yaozong1/Roam_pcba/(list of files, drawings)

Other design files:
roam.dsn
