yaozong1/Roam_pcba/roam.kicad_pcb

## KiCad design roam.kicad_pcb (2023-02-08)

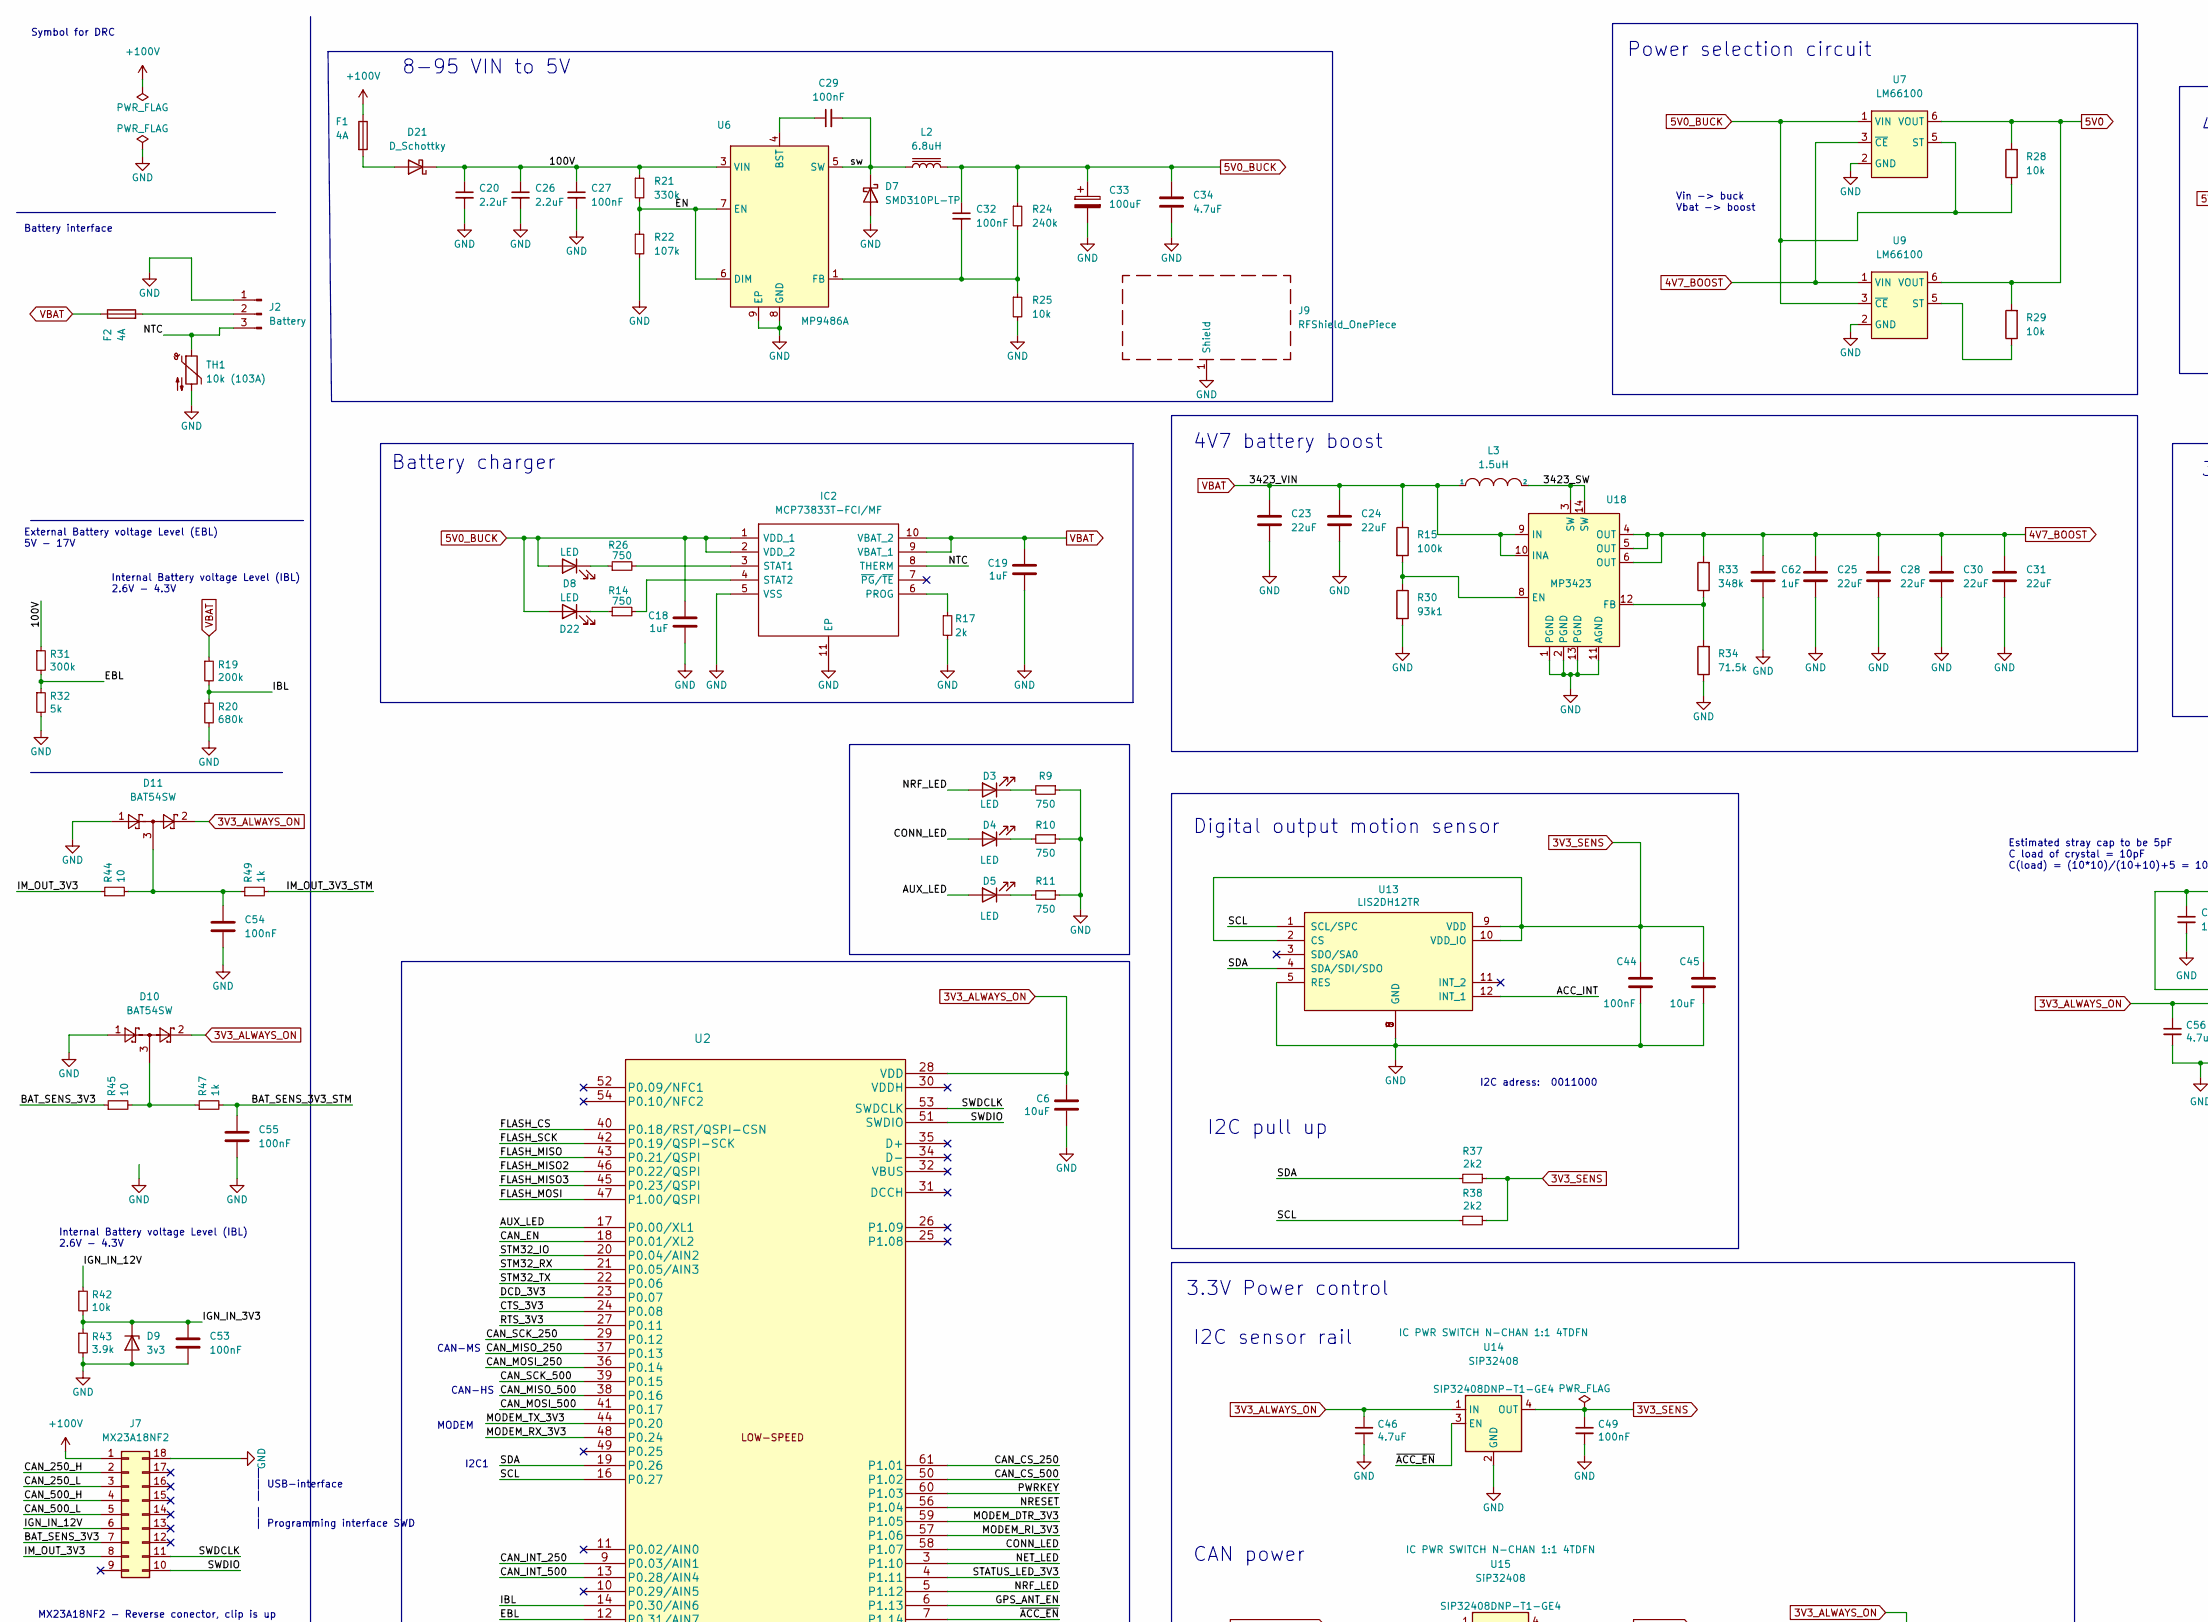
[picture p1: schematic roam.kicad_sch, part in row 1, column 1]

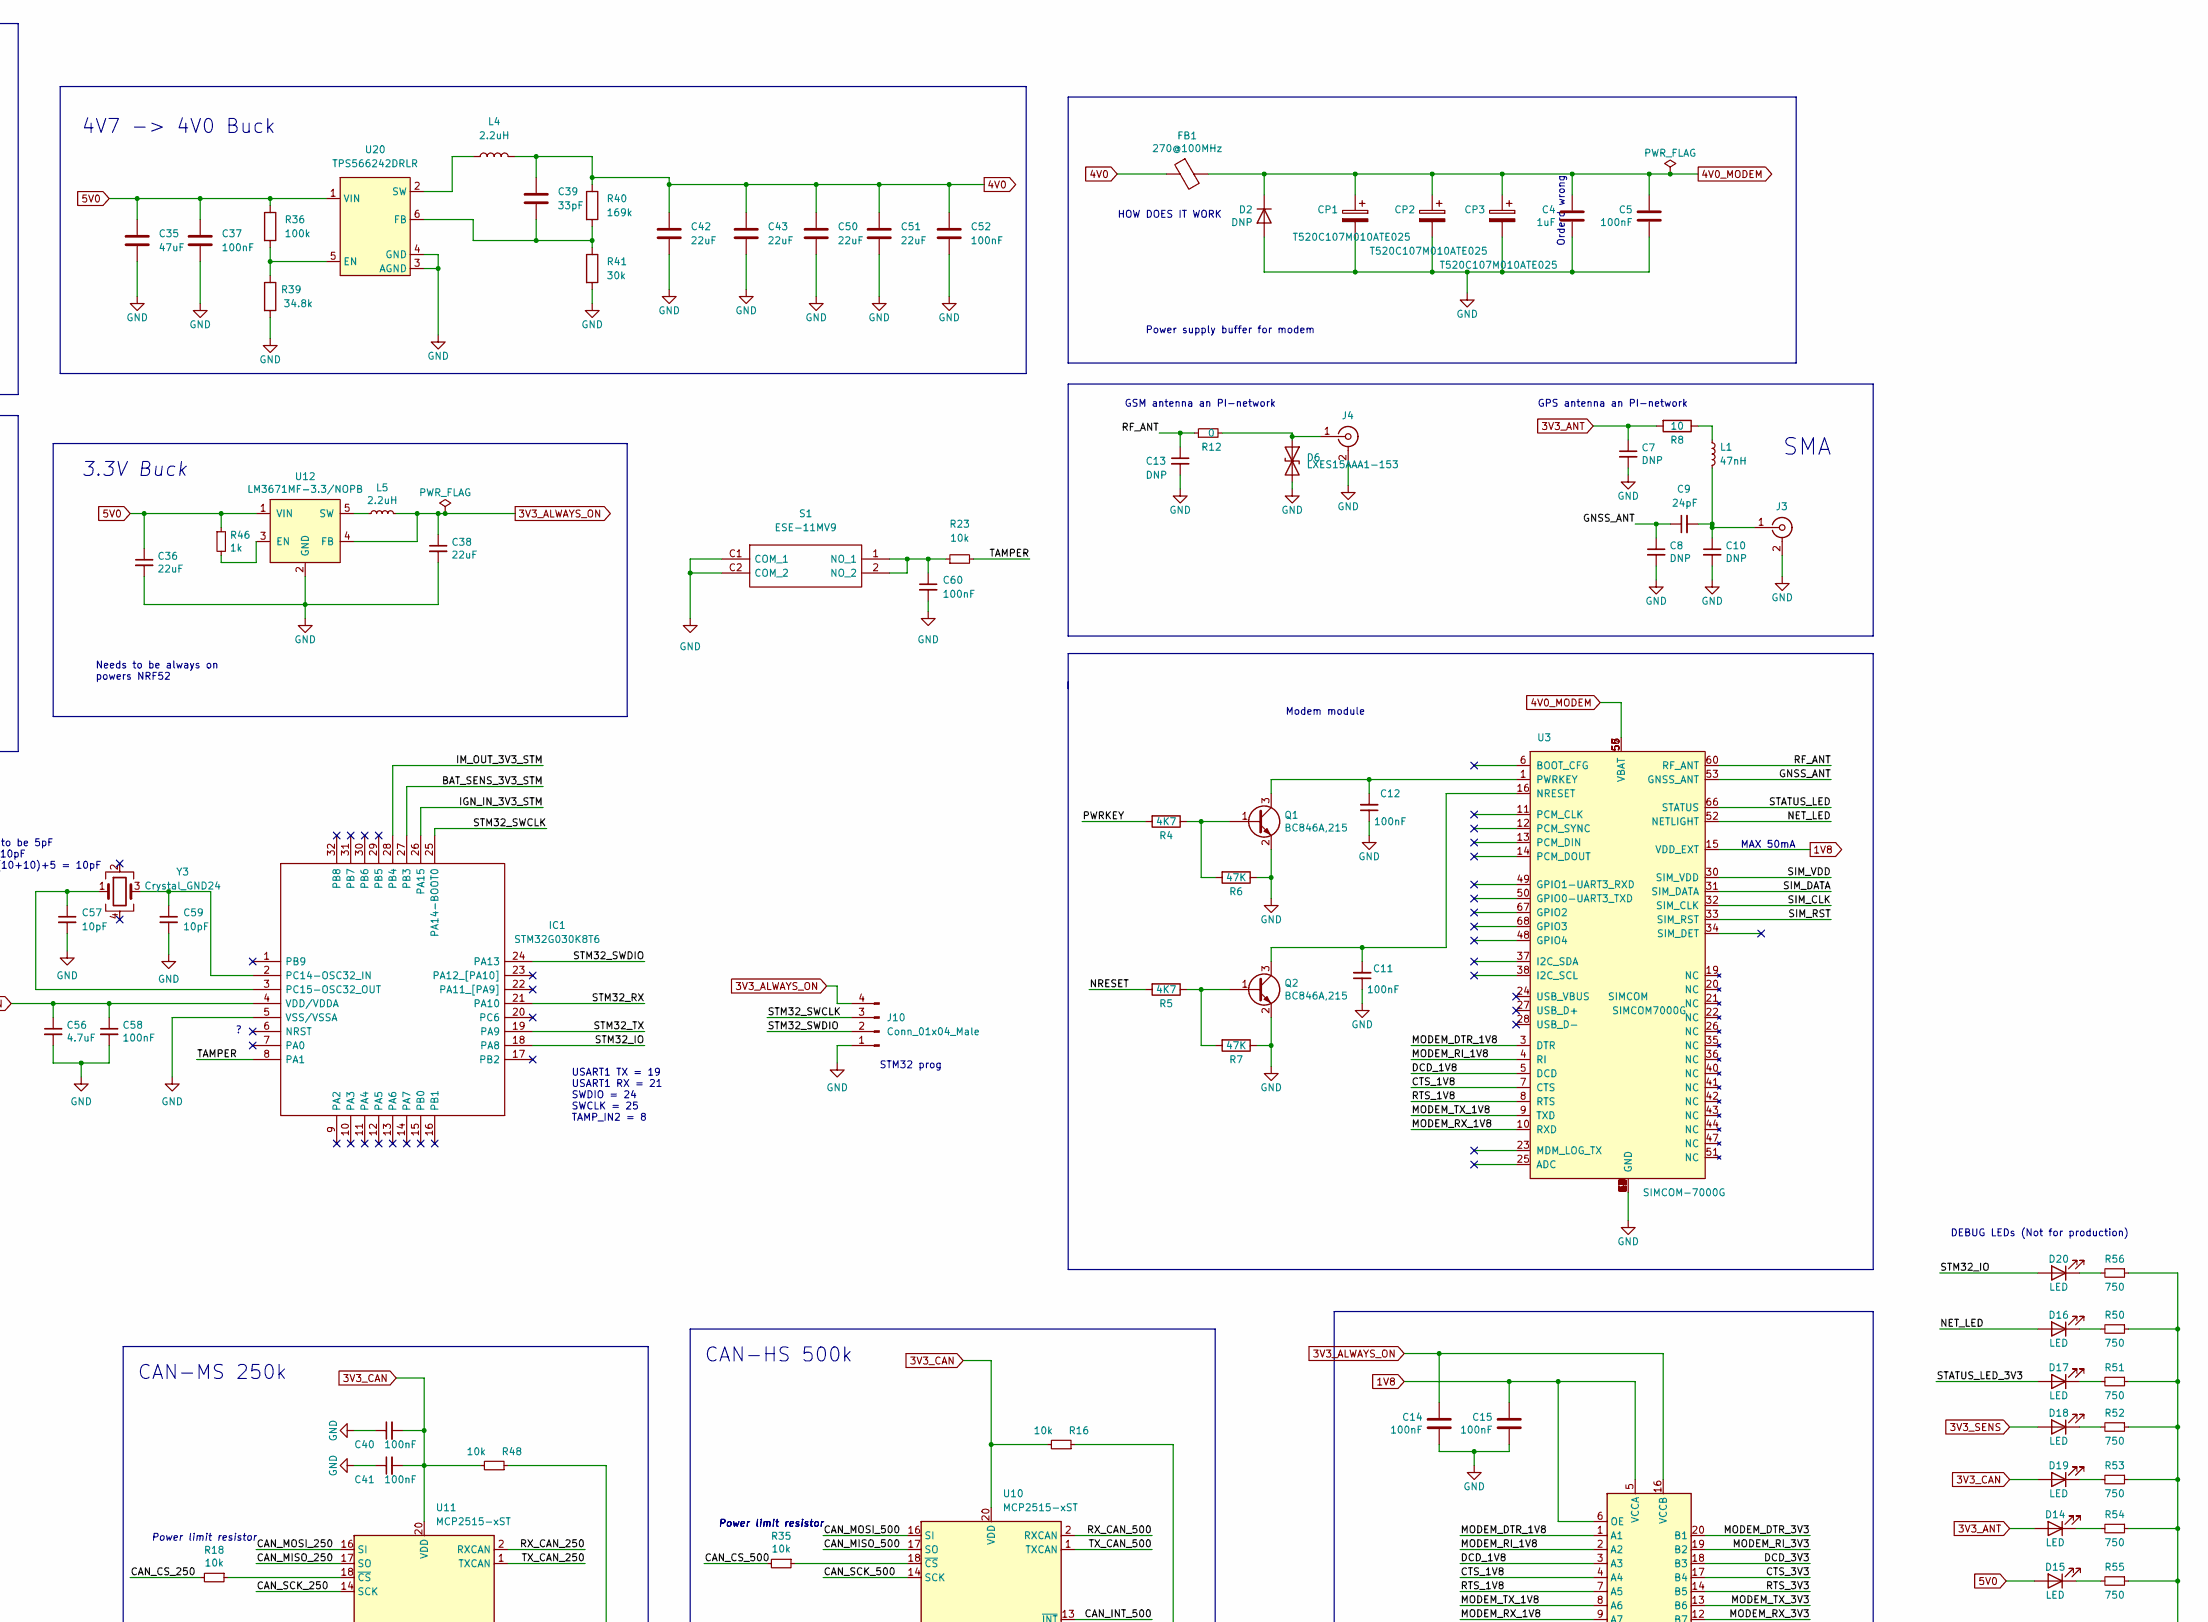
[picture p2: schematic roam.kicad_sch, part in row 1, column 2]

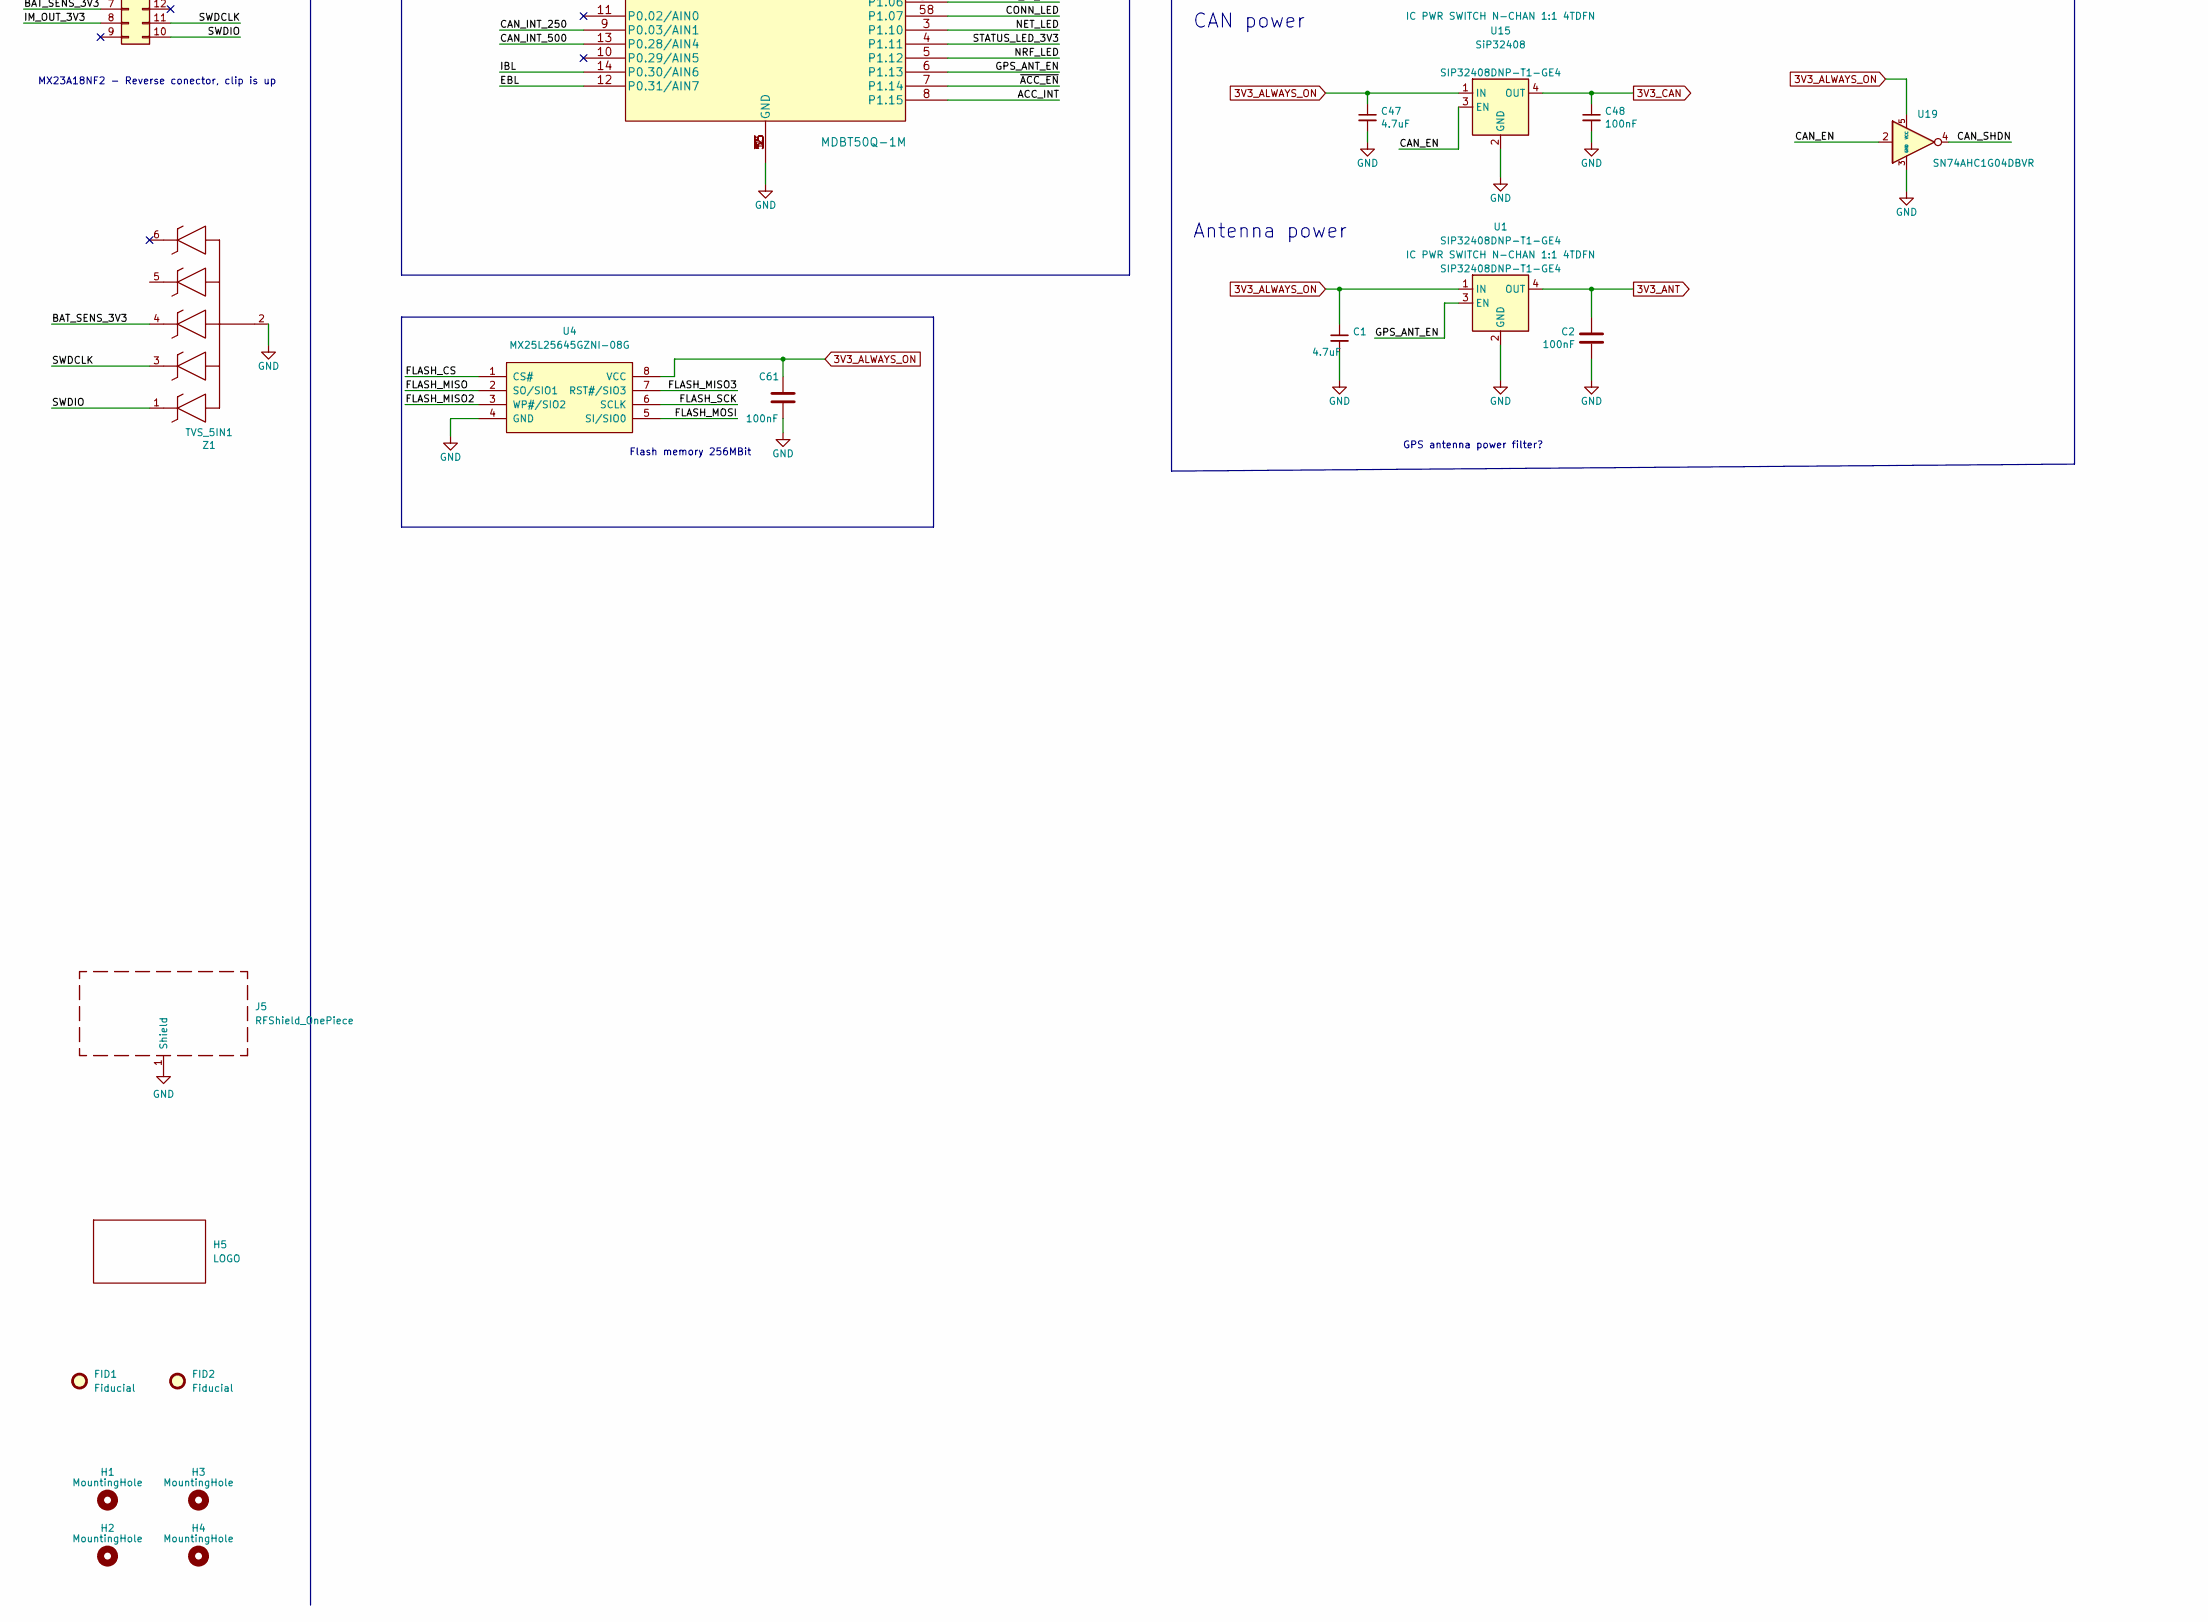
[picture p3: schematic roam.kicad_sch, part in row 2, column 1]

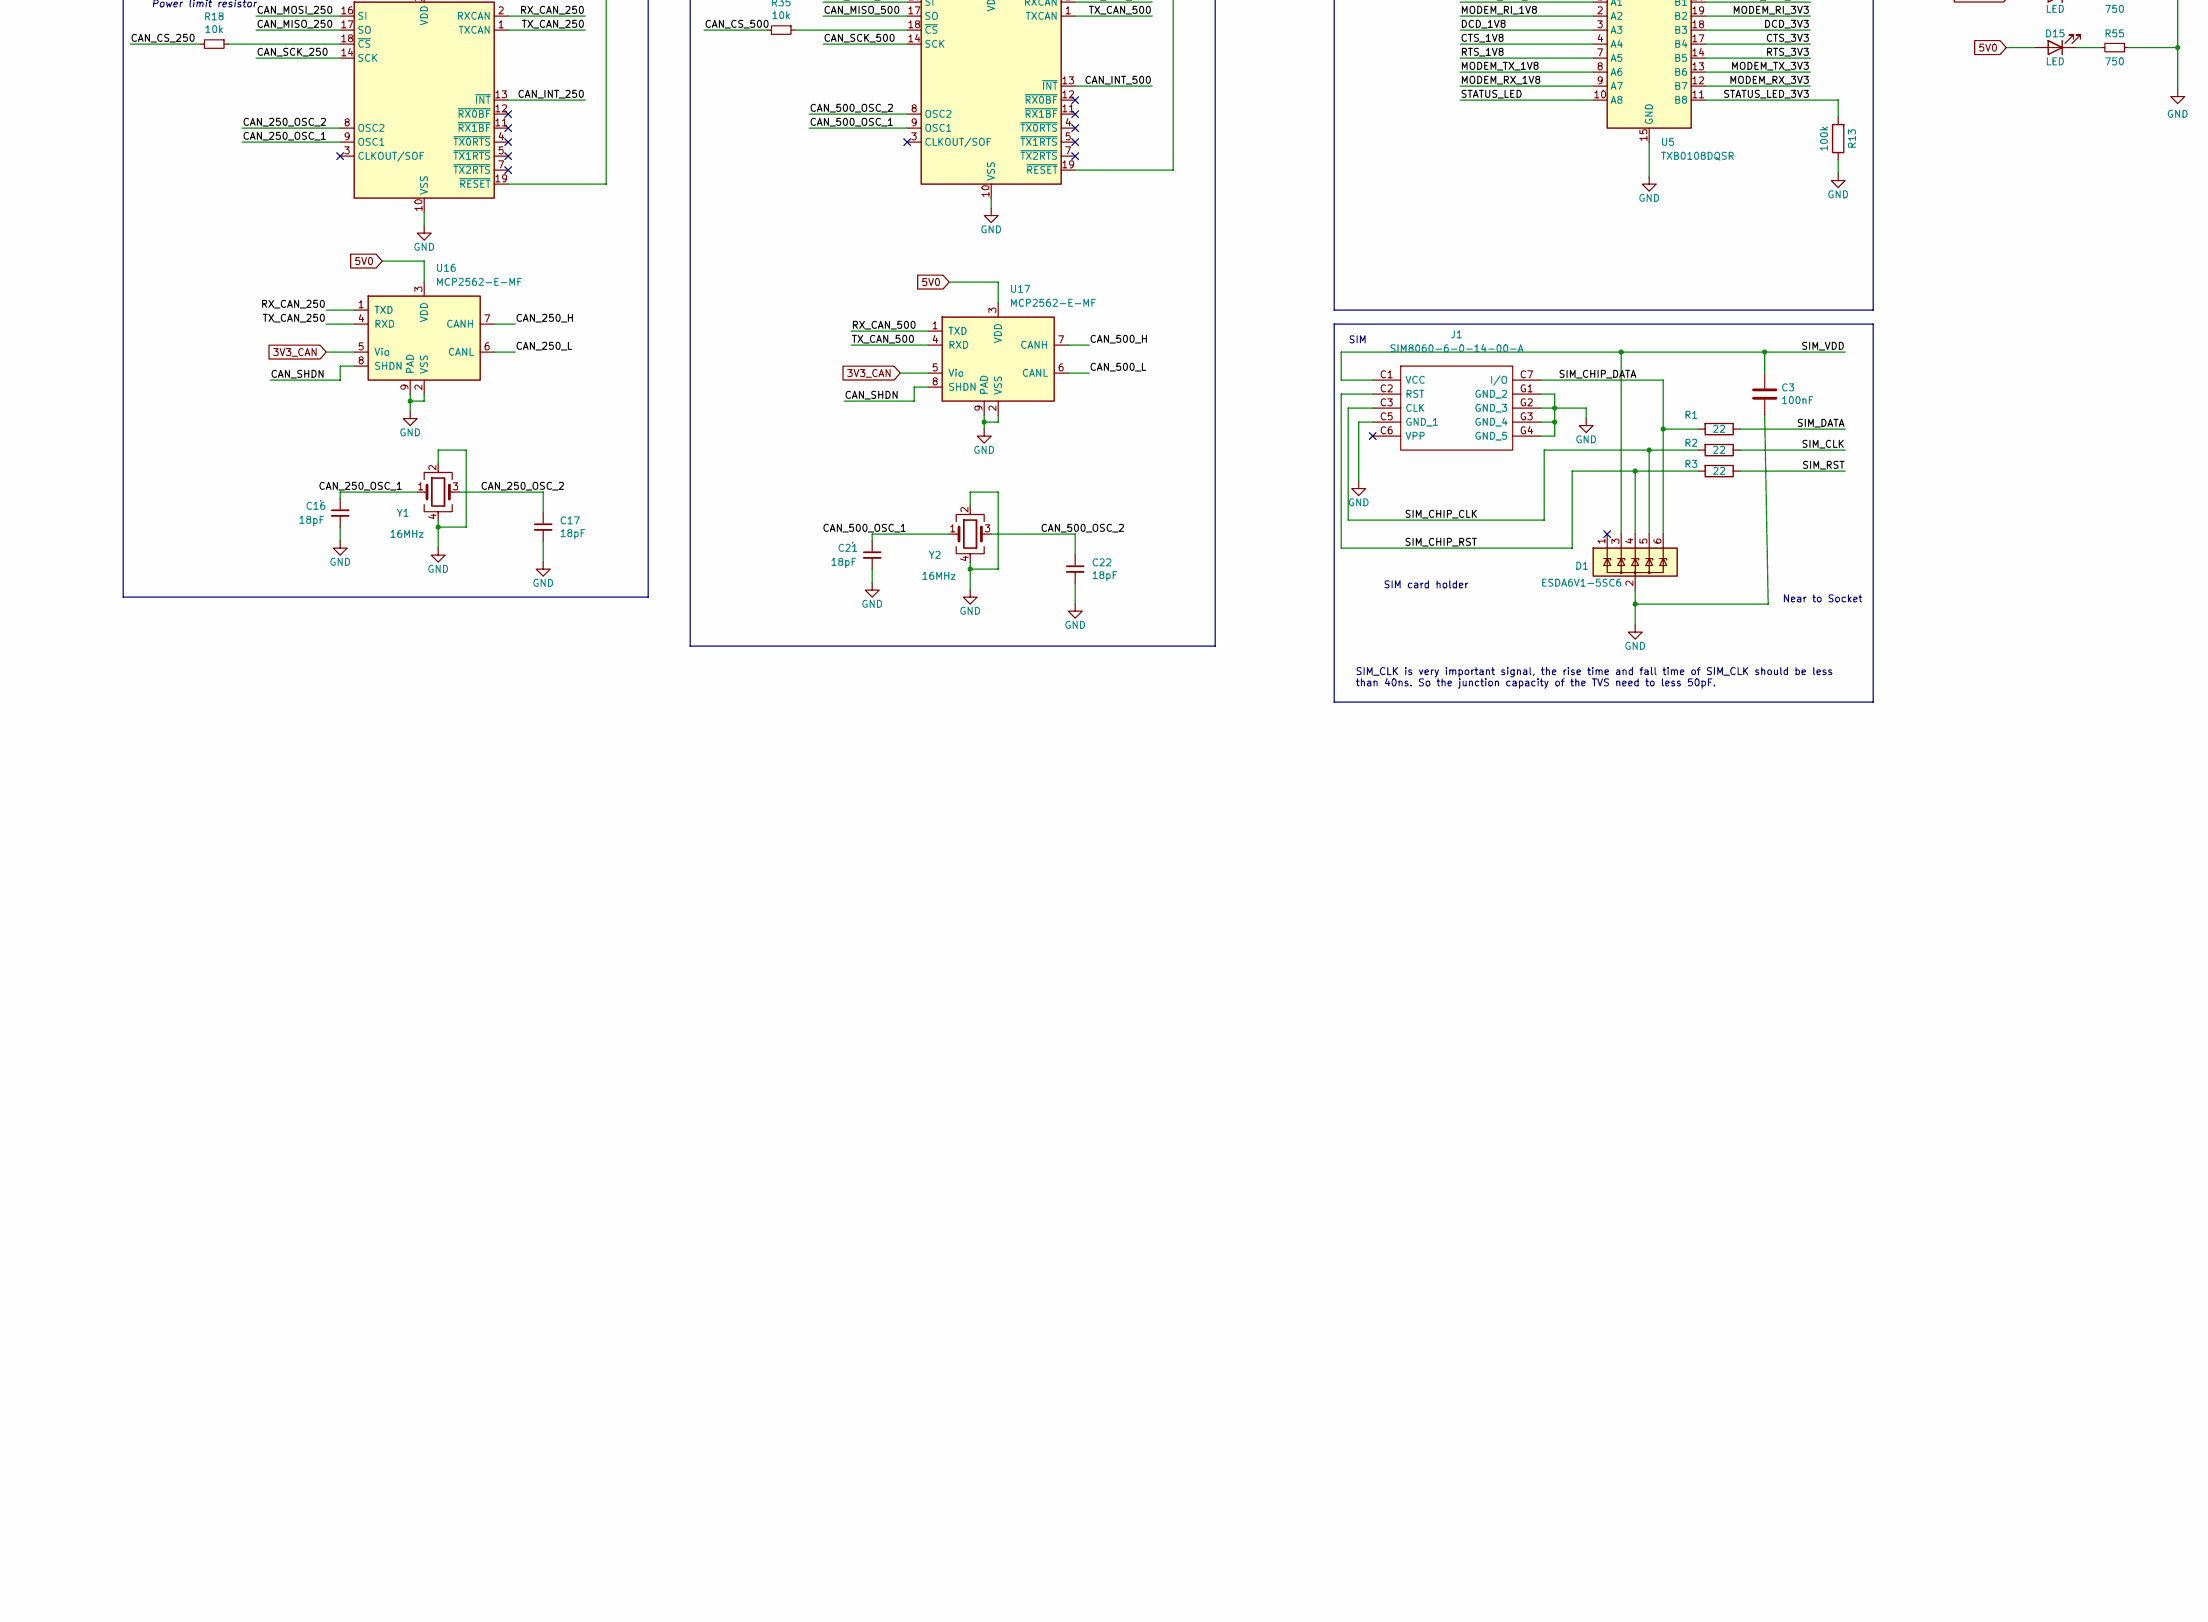
[picture p4: schematic roam.kicad_sch, part in row 2, column 2]

Parts:
C1, C46, C47, C56: 4.7uF; C_0603_1608Metric; MPN GRM188C71C475KE21D
C2, C3, C5, C11, C12, C14, C15, C37, C40, C41, C44, C48, C49, C53, C54, C55, C61: 100nF; C_0603_1608Metric; MPN 06036C104KAT4A
C4, C18, C19, C62: 1uF; C_0603_1608Metric; MPN JMK107BJ105MA-T
C6: 10uF; C_0603_1608Metric; MPN C1608X5R1A106M080AC; Digi-key PN 445-6853-1-ND
C7, C8, C10, C13: DNP; C_0402_1005Metric; MPN DNP
C9: 24pF; C_0402_1005Metric; MPN GRM1555C1H240JA01J
C16, C17, C21, C22: 18pF; C_0603_1608Metric; Rating C0G, NP0; MPN 251R14S180JV4T; Digi-key PN 712-1322-1-ND
C20, C26: 2.2uF; C_1206_3216Metric; MPN GRM31CC72A475KE11
C23, C24, C25, C28, C30, C31, C42, C43, C50, C51: 22uF; C_0805_2012Metric; MPN GRM21BR60J226M
C27: 100nF; C_0805_2012Metric; MPN GCM21BR72A104K
C29: 100nF; C_0603_1608Metric; MPN GRM188R72A104KA35
C32, C58: 100nF; C_0402_1005Metric; MPN 04026C104MAT2A
C33: 100uF; CP_EIA-6032-28_Kemet-C; MPN TR3C107M010C0200
C34: 4.7uF; C_0805_2012Metric; MPN GRM188C71C475KE21D
C35: 47uF; L_1206_3216Metric; MPN GRM31CR61A476KE15L
C36, C38: 22uF; C_0805_2012Metric; Rating X7S; MPN GRM21BR60J226M; Digi-key PN 1276-2909-1-ND
C39: 33pF; L_0402_1005Metric; MPN GRM1555C1E330JA01D
C45: 10uF; C_0603_1608Metric; Rating X5R; MPN C1608X5R1A106M080AC; Digi-key PN 445-6853-1-ND
C52: 100nF; L_0603_1608Metric; MPN 06036C104KAT4A
C57, C59: 10pF; C_0402_1005Metric; MPN 04026A100JAT2A
C60: 100nF; C_0603_1608Metric
CP1, CP2, CP3: T520C107M010ATE025; CP_EIA-6032-28_Kemet-C; MPN T520C107M010ATE025
D1: ESDA6V1-5SC6; SOT-23-6; MPN ESDA6V1-5SC6Y
D2: DNP; D_SOD-523; MPN T3V3S5-7
D3, D4, D5: LED; LED_0603_1608Metric; mpn QBLP601D-IG
D6: LXES15AAA1-153; D_0402_1005Metric; MPN LXES15AAA1-153
D7: SMD310PL-TP; D_SOD-123F; MPN SMD310PL-TP
D8, D22: LED; LED_0603_1608Metric; MPN SML-D12U1WT86
D9: 3v3; D_0603_1608Metric; MPN CZRU52C3
D10, D11: BAT54SW; SOT-323_SC-70; MPN BAT54SWFILMY
D14, D15, D16, D17, D18, D19, D20: LED; LED_0603_1608Metric; mpn LY L29K-H1K2-26-Z
D21: D_Schottky; TO-277A; MPN RB078RSM10STFTL1
F1, F2: 4A; Fuse_1206_3216Metric; MPN 0685T1000-01
FB1: 270@100MHz; R_1206_3216Metric; MPN BLM31KN271SZ1L
FID1, FID2: Fiducial; Fiducial_1mm_Mask2mm; MPN DNP
H1, H2, H3, H4: MountingHole; MountingHole_3.2mm_M3_DIN965_Pad; MPN DNP
H5: LOGO; THETC_LOGO_FOOTPRINT_MASK; MPN DNP
IC1: STM32G030K8T6; QFP80P900X900X160-32N; Manufacturer_Part_Number STM32G030K8T6; Mouser Part Number 511-STM32G030K8T6
IC2: MCP73833T-FCI/MF; SON50P300X300X100-11N-D; MPN MCP73833-CNI/MF
J1: SIM8060-6-0-14-00-A; SIM8060601400A; Manufacturer_Part_Number SIM8060-6-0-14-00-A; Mouser Part Number 640-SIM8060601400A
J2: Battery; Molex_PicoBlade_53047-0310_1x03_P1.25mm_Vertical; MPN 53047-0310
J3: U.FL-R-SMT-1-GNSS_ANT; coax-u.fl; MPN U.FL-R-SMT-1(40)
J4: U.FL-R-SMT-1-RF_ANT; coax-u.fl; MPN U.FL-R-SMT-1(40)
J5: RFShield_OnePiece; SMS-409N; MPN SMS-409-N-C
J7: MX23A18NF2; MX23A18NF1; MPN MX23A18NF2
J9: RFShield_OnePiece; SMS-455-N-F
J10: Conn_01x04_Male; PinHeader_1x04_P1.27mm_Vertical
L1: 47nH; L_0402_1005Metric; MPN MLK1005S47NJTD25
L2: 6.8uH; L_Taiyo-Yuden_NR-60xx; MPN NRS6045T6R8MMGK
L3: 1.5uH; L_Bourns-SRN4018; MPN MDWK4040T1R5MM
L4: 2.2uH; L_Bourns-SRN4018; MPN PA4332.222NLT
L5: 2.2uH; L_Taiyo-Yuden_MD-3030; MPN NRS3015T2R2MNGH; Digi-key PN 587-5933-1-ND
Q1, Q2: BC846A,215; SOT-23; MPN BC846A,215
R1, R2, R3: 22; R_0603_1608Metric; MPN CRGCQ0603J22R
R4, R5: 4K7; R_0603_1608Metric
R6, R7: 47K; R_0603_1608Metric
R8: 10; R_0402_1005Metric
R9, R10, R11, R14, R26, R50, R51, R52, R53, R54, R55, R56: 750; R_0603_1608Metric
R12: 0; R_0402_1005Metric
R13: 100k; R_0402_1005Metric; MPN 667-ERJ-2RKF1003X
R15: 100k; R_0603_1608Metric
R16, R18, R35, R48: 10k; R_0603_1608Metric; Digi-key PN RMCF0603FT10K0CT-ND
R17: 2k; R_0603_1608Metric; MPN ERJ-3EKF2001V
R19: 200k; R_0603_1608Metric; Digi-key PN RMCF0603FT200KCT-ND
R20: 680k; R_0603_1608Metric; Digi-key PN RMCF0603FT680KCT-ND
R21: 330k; R_0402_1005Metric; MPN SFR01MZPF3303
R22: 107k; R_0402_1005Metric; MPN CRCW0402107KFKEDC
R23, R42: 10k; R_0603_1608Metric
R24: 240k; R_0402_1005Metric; MPN CR0402-FX-2403GLF
R25, R28, R29: 10k; R_0402_1005Metric; MPN CRCW040210K0FKEDC
R30: 93k1; R_0603_1608Metric; MPN ERJ-2RKF9312X
R31: 300k; R_0603_1608Metric; MPN RC0201FR-07300KL
R32: 5k; R_0603_1608Metric; MPN AC0201FR-075K1L
R33: 348k; R_0402_1005Metric; MPN CR0603-FX-3483ELF
R34: 71.5k; R_0402_1005Metric; MPN CR0603-FX-7152ELF
R36: 100k; R_0402_1005Metric; MPN ERJ-2RKF1003X
R37, R38: 2k2; R_0603_1608Metric; Digi-key PN RMCF0603FT2K20CT-ND
R39: 34.8k; L_0402_1005Metric; MPN CR0603-FX-3482ELF
R40: 169k; L_0402_1005Metric; MPN CR0603-FX-1693ELF
R41: 30k; L_0402_1005Metric; MPN ERJ-3EKF3002V
R43: 3.9k; R_0603_1608Metric
R44, R45: 10; R_0603_1608Metric; MPN ERJ-3GEYJ100V
R46, R47, R49: 1k; R_0603_1608Metric
S1: ESE-11MV9; ESE11MV9; Manufacturer_Part_Number ESE-11MV9; Mouser Part Number 667-ESE-11MV9
TH1: 10k (103A); R_0603_1608Metric
U1: SIP32408DNP-T1-GE4; SON50P120X160X60-5N(TDFN-4); MPN SIP32408DNP-T1-GE4
U2: MDBT50Q-1M
U3: SIMCOM-7000G; SIM7000G; MPN SIMCOM7000G
U4: MX25L25645GZNI-08G; WSON-8-1EP_6x5mm_P1.27mm_EP3.4x4mm; MPN MX25L25645GZNI-08G
U5: TXB0108DQSR; USON-20_2x4mm_P0.4mm
U6: MP9486A; SOIC-8-1EP_3.9x4.9mm_P1.27mm_EP2.62x3.51mm_ThermalVias; MPN MP9486AGN
U7, U9: LM66100; SOT-363_SC-70-6; MPN LM66100
U10, U11: MCP2515-xST; TSSOP-20_4.4x6.5mm_P0.65mm; MPN MCP2515-xST
U12: LM3671MF-3.3/NOPB; SOT-23-5; MPN LM3671MF-3.3/NOPB; Digi-key PN LM3671MF-3.3/NOPBCT-ND
U13: LIS2DH12TR; LIS12DH; MPN LIS2DH12TR; Digi-key PN DNP
U14, U15: SiP32408; SON50P120X160X60-5N(TDFN-4); MPN SIP32408DNP-T1-GE4
U16, U17: MCP2562-E-MF; DFN-8-1EP_3x3mm_P0.65mm_EP1.55x2.4mm; MPN MCP2562-E-MF
U18: MP3423; MPN MP3423
U19: SN74AHC1G04DBVR; SOT-23-5; MPN SN74AHC1G04DBVR
U20: TPS566242DRLR; MPN TPS566242DRLR
Y1, Y2: 16MHz; Crystal_SMD_Abracon_ABM8G-4Pin_3.2x2.5mm; MPN ABM8-16.000MHZ-D1X-T; Digi-key PN 535-15015-1-ND
Y3: Crystal_GND24; Crystal_SMD_2016-4Pin_2.0x1.6mm_modified; MPN XRCGB32M000F2N13R0
Z1: TVS_5IN1; SOT-666; MPN PESD5V0U5BV; Digi-key PN 1727-5806-1-ND

Connections:
1V8: C15.1, U3.15 (VDD_EXT), U5.5 (VCCA), U5.6 (OE)
3V3_ALWAYS_ON: C1.1, C6.1, C14.1, C38.1, C46.1, C47.1, C56.1, C58.1, C61.1, D10.2, D11.2, IC1.4 (VDD/VDDA), J10.4, L5.2, U1.1 (IN), U2.28 (VDD), U4.8 (VCC), U5.16 (VCCB), U12.4 (FB), U14.1 (IN), U15.1 (IN), U19.5 (VCC)
3V3_ANT: C2.1, C7.1, D14.2 (A), R8.2, U1.4 (OUT)
3V3_CAN: C40.2, C41.2, C48.1, D19.2 (A), R16.2, R48.2, U10.20 (VDD), U11.20 (VDD), U15.4 (OUT), U16.5 (Vio), U17.5 (Vio)
3V3_SENS: C44.1, C45.1, C49.1, D18.2 (A), R37.1, R38.1, U13.2 (CS), U13.9 (VDD), U13.10 (VDD_IO), U14.4 (OUT)
4V0: C39.1, C42.1, C43.1, C50.1, C51.1, C52.1, FB1.1, L4.2, R40.1
4V0_MODEM: C4.1, C5.1, CP1.1, CP2.1, CP3.1, D2.1 (K), FB1.2, U3.55 (VBAT), U3.56 (VBAT), U3.57 (VBAT)
4V7_BOOST: C25.1, C28.1, C30.1, C31.1, C62.1, R33.2, U7.3 (~CE), U9.1 (VIN), U18.4 (OUT), U18.5 (OUT), U18.6 (OUT)
5V0: C35.1, C36.1, C37.1, D15.2 (A), R28.2, R29.2, R36.1, R46.1, U7.6 (VOUT), U9.6 (VOUT), U12.1 (VIN), U16.3 (VDD), U17.3 (VDD), U20.1 (VIN)
5V0_BUCK: C18.1, C32.1, C33.1, C34.1, D8.2 (A), D22.2 (A), IC2.1 (VDD_1), IC2.2 (VDD_2), L2.2, R24.1, R28.1, U7.1 (VIN), U7.5 (ST), U9.3 (~CE)
+100V: F1.1, J7.1; also elsewhere on the board
/100V: C20.1, C26.1, C27.1, D21.1 (K), R21.1, R31.1, U6.3 (VIN)
/3423_SW: L3.2, U18.3 (SW), U18.14 (SW)
/ACC_INT: U2.8 (P1.15), U13.12 (INT_1)
/AUX_LED: D5.2 (A), U2.17 (P0.00/XL1)
/BAT_SENS_3V3: J7.7, R45.1, Z1.4; also elsewhere on the board
/BAT_SENS_3V3_STM: C55.1, IC1.27 (PB3), R47.2
/CAN_250_H: J7.2, U16.7 (CANH); also elsewhere on the board
/CAN_250_L: J7.3, U16.6 (CANL); also elsewhere on the board
/CAN_250_OSC_1: C16.1, U11.9 (OSC1), Y1.1
/CAN_250_OSC_2: C17.1, U11.8 (OSC2), Y1.3
/CAN_500_H: J7.4, U17.7 (CANH); also elsewhere on the board
/CAN_500_L: J7.5, U17.6 (CANL); also elsewhere on the board
/CAN_500_OSC_1: C21.1, U10.9 (OSC1), Y2.1
/CAN_500_OSC_2: C22.1, U10.8 (OSC2), Y2.3
/CAN_CS_250: R18.2, U2.61 (P1.01)
/CAN_CS_500: R35.2, U2.50 (P1.02)
/CAN_EN: U2.18 (P0.01/XL2), U15.3 (EN), U19.2
/CAN_INT_250: U2.9 (P0.03/AIN1), U11.13 (~INT)
/CAN_INT_500: U2.13 (P0.28/AIN4), U10.13 (~INT)
/CAN_MISO_250: U2.37 (P0.13), U11.17 (SO)
/CAN_MISO_500: U2.38 (P0.16), U10.17 (SO)
/CAN_MOSI_250: U2.36 (P0.14), U11.16 (SI)
/CAN_MOSI_500: U2.41 (P0.17), U10.16 (SI)
/CAN_SCK_250: U2.29 (P0.12), U11.14 (SCK)
/CAN_SCK_500: U2.39 (P0.15), U10.14 (SCK)
/CAN_SHDN: U16.8 (SHDN), U17.8 (SHDN), U19.4
/CONN_LED: D4.2 (A), U2.58 (P1.07)
/CTS_1V8: U3.7 (CTS), U5.4 (A4)
/CTS_3V3: U2.24 (P0.08), U5.17 (B4)
/DCD_1V8: U3.5 (DCD), U5.3 (A3)
/DCD_3V3: U2.23 (P0.07), U5.18 (B3)
/EBL: R31.2, R32.1, U2.12 (P0.31/AIN7)
/EN: R21.2, R22.1, U6.6 (DIM), U6.7 (EN)
/FLASH_CS: U2.40 (P0.18/RST/QSPI-CSN), U4.1 (CS#)
/FLASH_MISO: U2.43 (P0.21/QSPI), U4.2 (SO/SIO1)
/FLASH_MISO2: U2.46 (P0.22/QSPI), U4.3 (WP#/SIO2)
/FLASH_MISO3: U2.45 (P0.23/QSPI), U4.7 (RST#/SIO3)
/FLASH_MOSI: U2.47 (P1.00/QSPI), U4.5 (SI/SIO0)
/FLASH_SCK: U2.42 (P0.19/QSPI-SCK), U4.6 (SCLK)
/GNSS_ANT: C8.1, C9.1, U3.53 (GNSS_ANT)
/GPS_ANT_EN: U1.3 (EN), U2.6 (P1.13)
/IBL: R19.2, R20.1, U2.14 (P0.30/AIN6)
/IGN_IN_3V3: C53.1, D9.1 (K), R42.2, R43.1
/IGN_IN_3V3_STM: IC1.26 (PA15)
/IGN_IN_12V: J7.6, R42.1; also elsewhere on the board
/IM_OUT_3V3: J7.8, R44.1; also elsewhere on the board
/IM_OUT_3V3_STM: IC1.28 (PB4), R49.2
/MODEM_DTR_1V8: U3.3 (DTR), U5.1 (A1)
/MODEM_DTR_3V3: U2.59 (P1.05), U5.20 (B1)
/MODEM_RI_1V8: U3.4 (RI), U5.2 (A2)
/MODEM_RI_3V3: U2.57 (P1.06), U5.19 (B2)
/MODEM_RX_1V8: U3.10 (RXD), U5.9 (A7)
/MODEM_RX_3V3: U2.48 (P0.24), U5.12 (B7)
/MODEM_TX_1V8: U3.9 (TXD), U5.8 (A6)
/MODEM_TX_3V3: U2.44 (P0.20), U5.13 (B6)
/NET_LED: D16.2 (A), U2.3 (P1.10), U3.52 (NETLIGHT)
/NRESET: R5.2, U2.56 (P1.04)
/NRF_LED: D3.2 (A), U2.5 (P1.12)
/NTC: IC2.8 (THERM), J2.3, TH1.1
/PWRKEY: R4.2, U2.60 (P1.03)
/RF_ANT: C13.1, R12.1, U3.60 (RF_ANT)
/RTS_1V8: U3.8 (RTS), U5.7 (A5)
/RTS_3V3: U2.27 (P0.11), U5.14 (B5)
/RX_CAN_250: U11.2 (RXCAN), U16.1 (TXD)
/RX_CAN_500: U10.2 (RXCAN), U17.1 (TXD)
/SCL: R38.2, U2.16 (P0.27), U13.1 (SCL/SPC)
/SDA: R37.2, U2.19 (P0.26), U13.4 (SDA/SDI/SDO)
/SIM_CHIP_CLK: D1.5 (IO4), J1.C3 (CLK), R2.2
/SIM_CHIP_DATA: D1.6 (IO5), J1.C7 (I/O), R1.2
/SIM_CHIP_RST: D1.4 (IO3), J1.C2 (RST), R3.2
/SIM_CLK: R2.1, U3.32 (SIM_CLK)
/SIM_DATA: R1.1, U3.31 (SIM_DATA)
/SIM_RST: R3.1, U3.33 (SIM_RST)
/SIM_VDD: C3.1, D1.3 (IO2), J1.C1 (VCC), U3.30 (SIM_VDD)
/STATUS_LED: U3.66 (STATUS), U5.10 (A8)
/STATUS_LED_3V3: D17.2 (A), R13.2, U2.4 (P1.11), U5.11 (B8)
/STM32_IO: D20.2 (A), IC1.18 (PA8), U2.20 (P0.04/AIN2)
/STM32_RX: IC1.21 (PA10), U2.21 (P0.05/AIN3)
/STM32_SWCLK: IC1.25 (PA14-BOOT0), J10.3
/STM32_SWDIO: IC1.24 (PA13), J10.2
/STM32_TX: IC1.19 (PA9), U2.22 (P0.06)
/SWDCLK: J7.11, U2.53 (SWDCLK), Z1.3; also elsewhere on the board
/SWDIO: J7.10, U2.51 (SWDIO), Z1.1; also elsewhere on the board
/TAMPER: IC1.8 (PA1), R23.2
/TX_CAN_250: U11.1 (TXCAN), U16.4 (RXD)
/TX_CAN_500: U10.1 (TXCAN), U17.4 (RXD)
/sw: C29.2, D7.1 (K), L2.1, U6.5 (SW)
/~ACC_EN: U2.7 (P1.14), U14.3 (EN)
GND: C1.2, C2.2, C3.2, C4.2, C5.2, C6.2, C7.2, C8.2, C10.2, C11.1, C12.1, C13.2, C14.2, C15.2, C16.2, C17.2, C18.2, C19.2, C20.2, C21.2, C22.2, C23.2, C24.2, C25.2, C26.2, C27.2, C28.2, C30.2, C31.2, C33.2, C34.2, C35.2, C36.2, C37.2, C38.2, C40.1, C41.1, C42.2, C43.2, C44.2, C45.2, C46.2, C47.2, C48.2, C49.2, C50.2, C51.2, C52.2, C53.2, C54.2, C55.2, C56.2, C57.2, C58.2, C59.2, C60.2, C61.2, C62.2, CP1.2, CP2.2, CP3.2, D1.2 (GND), D2.2 (A), D6.2 (A2), D7.2 (A), D9.2 (A), D10.1, D11.1, IC1.5 (VSS/VSSA), IC2.5 (VSS), IC2.11 (EP), J1.C5 (GND_1), J1.G1 (GND_2), J1.G2 (GND_3), J1.G3 (GND_4), J1.G4 (GND_5), J2.1, J3.2 (Ext), J4.2 (Ext), J5.1 (Shield), J7.18, J9.1 (Shield), J10.1, Q1.2 (E), Q2.2 (E), R6.1, R7.1, R9.1, R10.1, R11.1, R13.1, R17.2, R20.2, R22.2, R25.2, R30.2, R32.2, R34.1, R39.2, R41.2, R43.2, R50.1, R51.1, R52.1, R53.1, R54.1, R55.1, R56.1, S1.C1 (COM_1), S1.C2 (COM_2), TH1.2, U1.2 (GND), U1.5 (GND), U2.1 (GND), U2.2 (GND), U2.15 (GND), U2.33 (GND), U2.55 (GND), U3.2 (GND), U3.17 (GND), U3.18 (GND), U3.29 (GND), U3.39 (GND), U3.45 (GND), U3.46 (GND), U3.54 (GND), U3.58 (GND), U3.59 (GND), U3.61 (GND), U3.62 (GND), U3.63 (GND), U3.64 (GND), U3.65 (GND), U4.4 (GND), U5.15 (GND), U6.8 (GND), U6.9 (EP), U7.2 (GND), U9.2 (GND), U10.10 (VSS), U11.10 (VSS), U12.2 (GND), U13.5 (RES), U13.6 (GND), U13.7 (GND), U13.8 (GND), U14.2 (GND), U14.5 (GND), U15.2 (GND), U15.5 (GND), U16.2 (VSS), U16.9 (PAD), U17.2 (VSS), U17.9 (PAD), U18.1 (PGND), U18.2 (PGND), U18.11 (AGND), U18.13 (PGND), U19.3 (GND), U20.3 (AGND), U20.4 (GND), Y1.2, Y1.4, Y2.2, Y2.4, Z1.2; also elsewhere on the board
unnamed: C9.2, C10.1, J3.1 (In), L1.2
unnamed: C11.2, Q2.3 (C), U3.16 (NRESET)
unnamed: C12.2, Q1.3 (C), U3.1 (PWRKEY)
unnamed: C29.1, U6.4 (BST)
unnamed: C32.2, R24.2, R25.1, U6.1 (FB)
unnamed: C39.2, R40.2, R41.1, U20.6 (FB)
unnamed: C54.1, D11.3, R44.2, R49.1
unnamed: C57.1, IC1.3 (PC15-OSC32_OUT), Y3.1
unnamed: C59.1, IC1.2 (PC14-OSC32_IN), Y3.3
unnamed: C60.1, R23.1, S1.1 (NO_1), S1.2 (NO_2)
unnamed: D3.1 (K), R9.2
unnamed: D4.1 (K), R10.2
unnamed: D5.1 (K), R11.2
unnamed: D6.1 (A1), J4.1 (In), R12.2
unnamed: D8.1 (K), R26.1
unnamed: D10.3, R45.2, R47.1
unnamed: D14.1 (K), R54.2
unnamed: D15.1 (K), R55.2
unnamed: D16.1 (K), R50.2
unnamed: D17.1 (K), R51.2
unnamed: D18.1 (K), R52.2
unnamed: D19.1 (K), R53.2
unnamed: D20.1 (K), R56.2
unnamed: D21.2 (A), F1.2
unnamed: D22.1 (K), R14.1
unnamed: F2.2, J2.2
unnamed: IC2.3 (STAT1), R26.2
unnamed: IC2.4 (STAT2), R14.2
unnamed: IC2.6 (PROG), R17.1
unnamed: L1.1, R8.1
unnamed: L4.1, U20.2 (SW)
unnamed: L5.1, U12.5 (SW)
unnamed: Q1.1 (B), R4.1, R6.2
unnamed: Q2.1 (B), R5.1, R7.2
unnamed: R15.2, R30.1, U18.8 (EN)
unnamed: R16.1, U10.19 (~RESET)
unnamed: R18.1, U11.18 (~CS)
unnamed: R29.1, U9.5 (ST)
unnamed: R33.1, R34.2, U18.12 (FB)
unnamed: R35.1, U10.18 (~CS)
unnamed: R36.2, R39.1, U20.5 (EN)
unnamed: R46.2, U12.3 (EN)
unnamed: R48.1, U11.19 (~RESET)
VBAT: C19.1, C23.1, C24.1, F2.1, IC2.9 (VBAT_1), IC2.10 (VBAT_2), L3.1, R15.1, R19.1, U18.9 (IN), U18.10 (INA)

Notes on the sheet:
I2C pull up
Orderd wrong
HOW DOES IT WORK
Digital output motion sensor
Modem module
Estimated stray cap to be 5pF C load of crystal = 10pF C(load) = (10*10)/(10+10)+5 = 10pF
External Battery voltage Level (EBL) 5V - 17V
Power limit resistor
CAN-HS
SIM card holder
GSM antenna an PI-network
I2C1
CAN-MS
MAX 50mA
SIM
3.3V Power control
I2C sensor rail
Antenna power
| | USB-interface |
| | Programming interface SWD
CAN-HS 500k
Battery interface
Flash memory 256MBit
SMA
4V7 battery boost
Needs to be always on powers NRF52
MODEM
Battery charger
Symbol for DRC
DEBUG LEDs (Not for production)
SIM_CLK is very important signal, the rise time and fall time of SIM_CLK should be less than 40ns. So the junction capacity of the TVS need to less 50pF.
Power selection circuit
Internal Battery voltage Level (IBL) 2.6V - 4.3V
I2C adress: 0011000
USART1 TX = 19 USART1 RX = 21 SWDIO = 24 SWCLK = 25 TAMP_IN2 = 8
CAN power
CAN-MS 250k
4V7 -> 4V0 Buck
8-95 VIN to 5V
STM32 prog
3.3V Buck
Near to Socket
Vin -> buck Vbat -> boost
GPS antenna power filter?
Power supply buffer for modem
MX23A18NF2 - Reverse conector, clip is up
GPS antenna an PI-network
