yaozong1/Roam_pcba/roam.kicad_pcb

## KiCad design roam.kicad_pcb (continued)

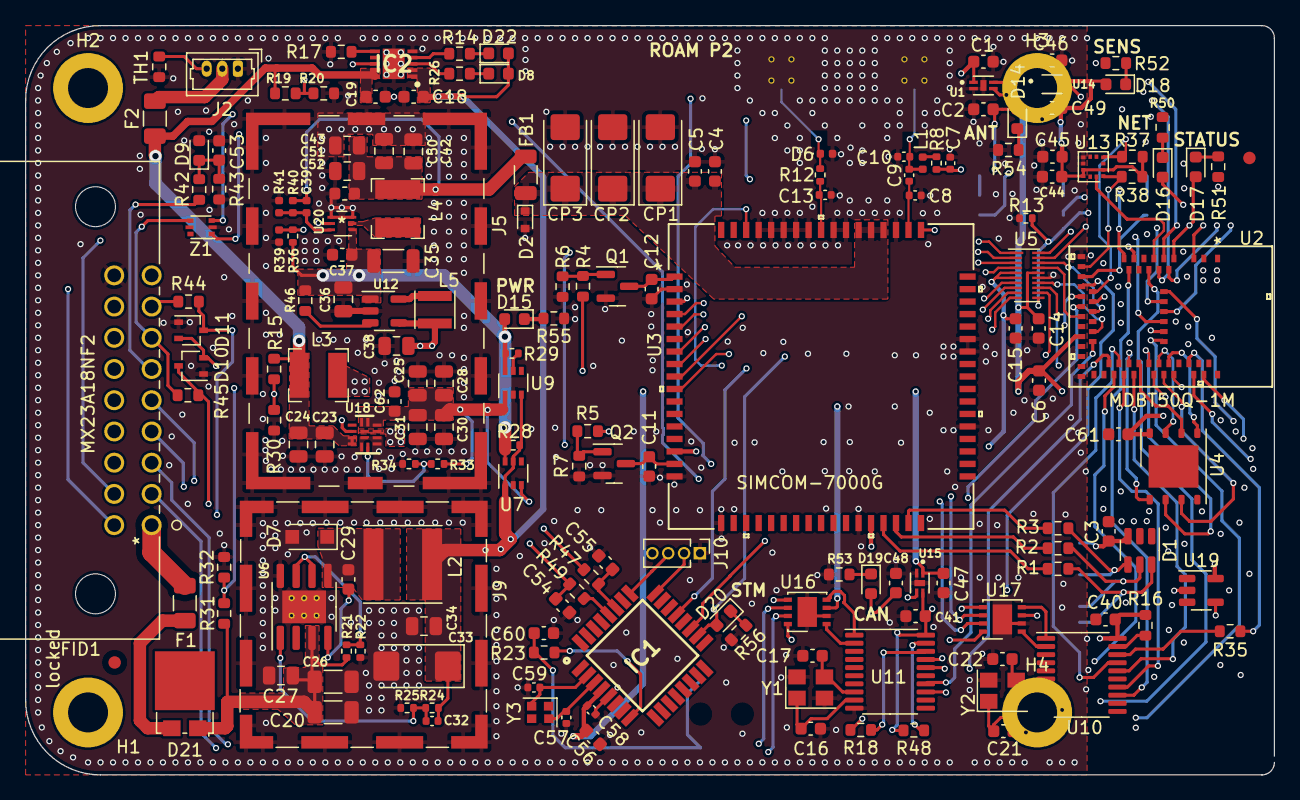
[picture p5: board roam.kicad_pcb from above]

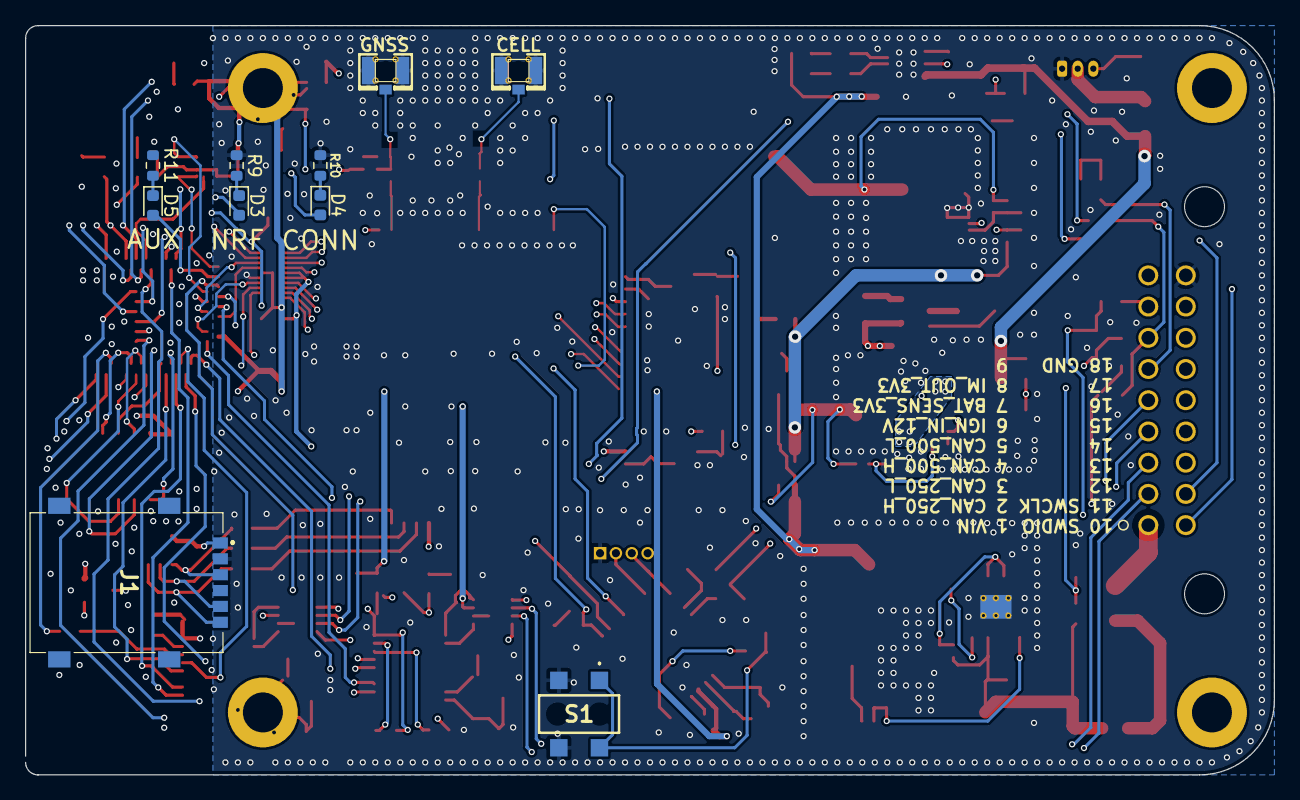
[picture p6: board roam.kicad_pcb from below]

Board: 4 copper layers, 100.0 x 60.0 mm, 192 parts (10 on the bottom side), 143 nets.

Other parts of the board:
locked: MX23A18NF2; MX23A18NF1

Their connections:
+100V: locked.1; also elsewhere on the board
/BAT_SENS_3V3: locked.7; also elsewhere on the board
/CAN_250_H: locked.2; also elsewhere on the board
/CAN_250_L: locked.3; also elsewhere on the board
/CAN_500_H: locked.4; also elsewhere on the board
/CAN_500_L: locked.5; also elsewhere on the board
/IGN_IN_12V: locked.6; also elsewhere on the board
/IM_OUT_3V3: locked.8; also elsewhere on the board
/SWDCLK: locked.11; also elsewhere on the board
/SWDIO: locked.10; also elsewhere on the board
GND: locked.18; also elsewhere on the board
