yaozong1/Roam_pcba/(commit log)

2022-12-15 Placed sketch components
    [roam.kicad_pcb, roam.kicad_sch]
2022-12-20 Reduced component count
    [roam.kicad_pcb, roam.kicad_sch]
2022-12-21 Updated smaller footprint
    [roam.kicad_pcb, roam.kicad_sch]
2022-12-26 Worked on connector
    [roam.dsn, roam.kicad_pcb, roam.kicad_sch]
2022-12-28 Draw 95V
    [roam.kicad_pcb, roam.kicad_sch]
2022-12-28 added 3d models for missing parts
    [roam.kicad_pcb]
2022-12-29 Added DC booster
    [roam.kicad_pcb, roam.kicad_sch]
2023-01-02 Component selection in progress
    [roam.kicad_pcb, roam.kicad_sch]
2023-01-05 Added Digi-key PN to all components
    [roam.kicad_pcb]
2023-01-23 phase 2 start
    [roam-B_Cu.gbr, roam-B_Mask.gbr, roam-B_Paste.gbr, roam-B_Silkscreen.gbr, roam-Edge_Cuts.gbr, roam-F_Cu.gbr, roam-F_Mask.gbr, roam-F_Paste.gbr]
2023-01-26 single shield on vin dcdc
    [roam.kicad_pcb, roam.kicad_sch]
2023-01-31 updated layout, not done
    [roam.kicad_pcb, roam.kicad_sch]
2023-01-31 Done, execpt ERC
    [roam.kicad_pcb, roam.kicad_sch]
2023-02-01 ready for production
    [roam.kicad_pcb, roam.kicad_sch]
2023-02-01 changed tvs diodes and added missing cupper fill
    [roam.kicad_pcb, roam.kicad_sch]
2023-02-02 gerber sent to production
    [roam-B_Cu.gbr, roam-B_Mask.gbr, roam-B_Paste.gbr, roam-B_Silkscreen.gbr, roam-Edge_Cuts.gbr, roam-F_Cu.gbr, roam-F_Mask.gbr, roam-F_Paste.gbr]
2023-02-08 gsm antenna template
    [roam.kicad_pcb]
2023-02-09 tc-kicad-comp folder
